dmsmith1991/RainbowBadge/Hardware/avr-6-pin-isp-cable.jpg

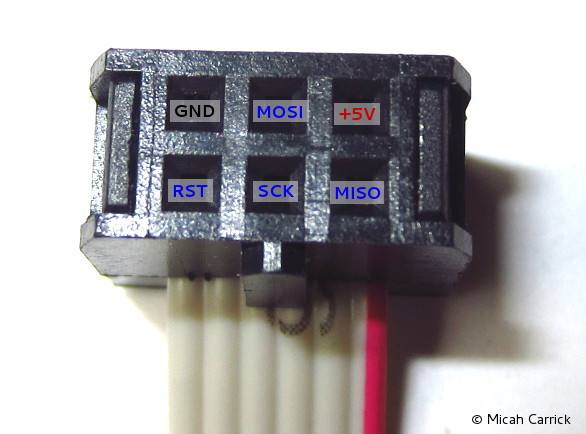
Hardware/avr-6-pin-isp-cable.jpg
