dmsmith1991/RainbowBadge/Hardware/avrpogo2.jpg

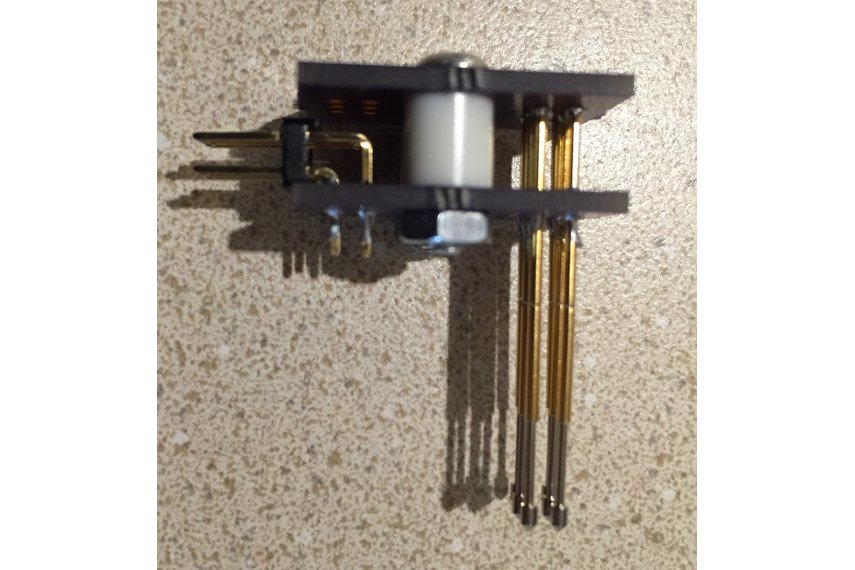
Hardware/avrpogo2.jpg
