dmsmith1991/RainbowBadge/Software/Badge Pattern Customiser.docx

Events

- Tactile Button Press (1-4 buttons)
- Countdown (in Milliseconds)
- Shake (Accelerometer)

Badge Interface Protocol

Communication interface: Serial over USB, 9600 baud 8N1.

Commands

1) Return Firmware Information
  a. ?
  b. Response: RainbowBadgeDemoFW V1.00
2) Clear Receive Buffer
  a. –
  b. Response: CLR
3) SetEvent
  a. E[0] = 1,2
    i. E is the command keychar.
    ii. 0 is the event type (button 1 pressed, button 2 pressed, shake etc.).
    iii. Values after the equals sign are event specific configuration values. These include the enabled state of the event, the event action (what to do when the event is detected e.g. goto next frame, goto previous frame, goto specific frame, goto random frame, increase brightness, decrease brightness etc.).
4) Set Frame Pointer
  a. F = 0
    i. F is the command keychar.
    ii. 0 is the frame index.
  b. Used to point to a specific frame when changing it’s LED colours etc.
5) Set Number Of Frames
  a. N = 0
    i. N is the command keychar.
    ii. 0 is the number of frames stored in EEPROM.
6) Set LED Colour (applies to LEDs in current frame)
  a. L[0] = 255,255,255
    i. L is the command keychar.
    ii. 0 is the LED index (0-24).
    iii. First curly brace argument is the Red colour value.
    iv. Second curly brace argument is the Green colour value.
    v. Third curly brace argument is the Blue colour value.
7) Set Global LED Brightness (on badge poweron)
  a. B = 0
    i. B is the command keychar.
    ii. 0 is the brightness (10 - 250).
