dmsmith1991/RainbowBadge/Hardware/avrpogo1.jpg

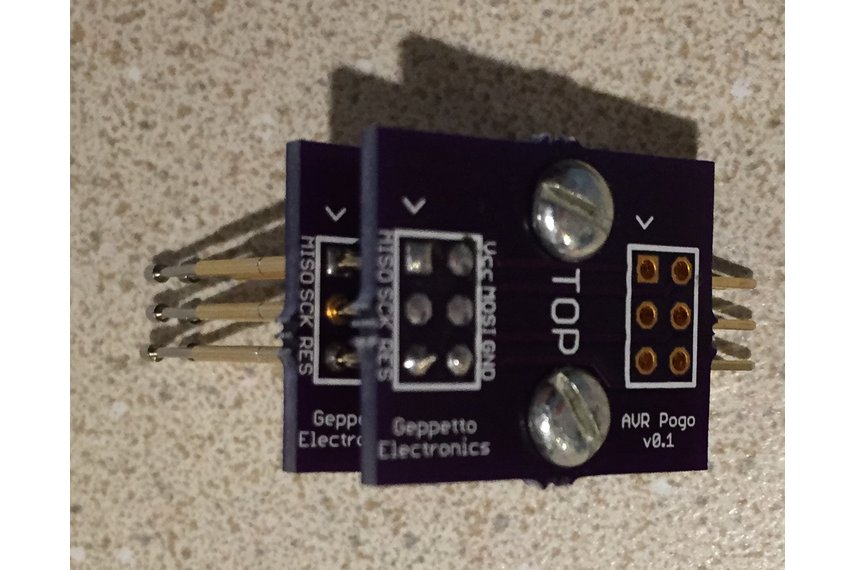
Hardware/avrpogo1.jpg
