dmsmith1991/RainbowBadge/Hardware/DipTrace/OSHPark Renders/Rev. A/bottom.png

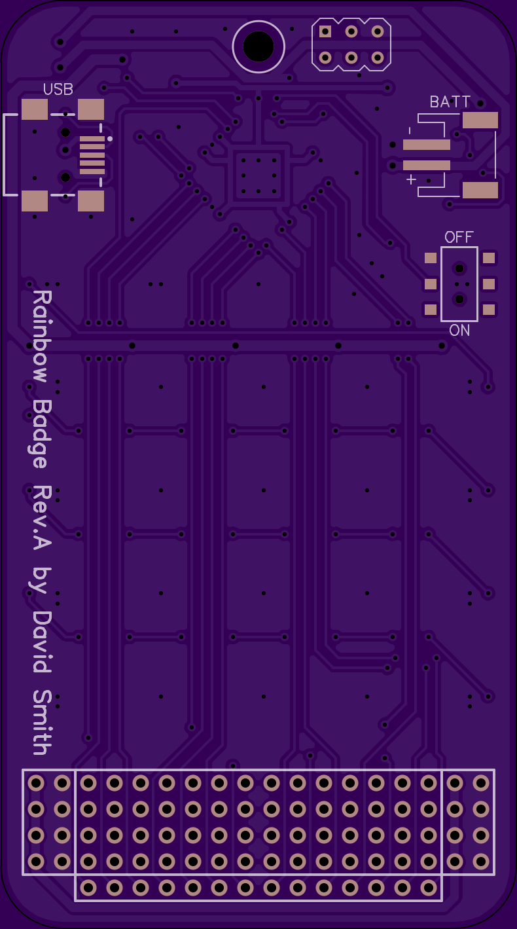
Hardware/DipTrace/OSHPark Renders/Rev. A/bottom.png
