dmsmith1991/RainbowBadge/Hardware/DipTrace/OSHPark Renders/Rev. A/top.png

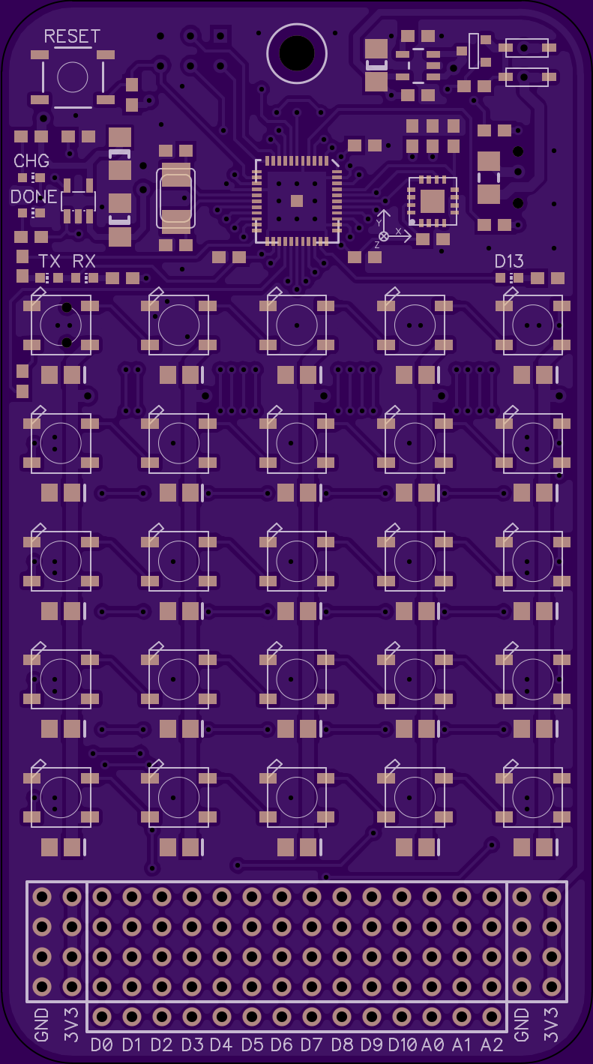
Hardware/DipTrace/OSHPark Renders/Rev. A/top.png
