dmsmith1991/RainbowBadge/Images/2015-01-17 16.46.09.jpg

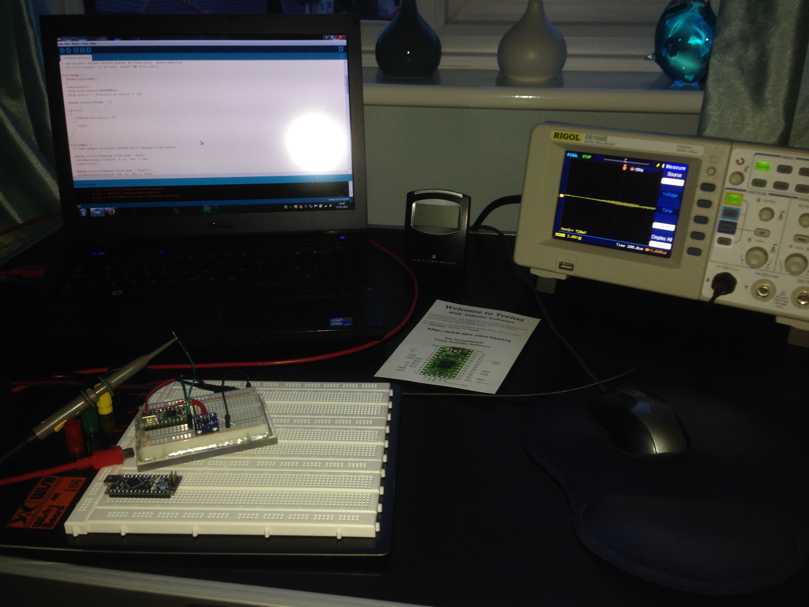
Images/2015-01-17 16.46.09.jpg
