dmsmith1991/RainbowBadge/Images/2015-05-24 18.30.36.jpg

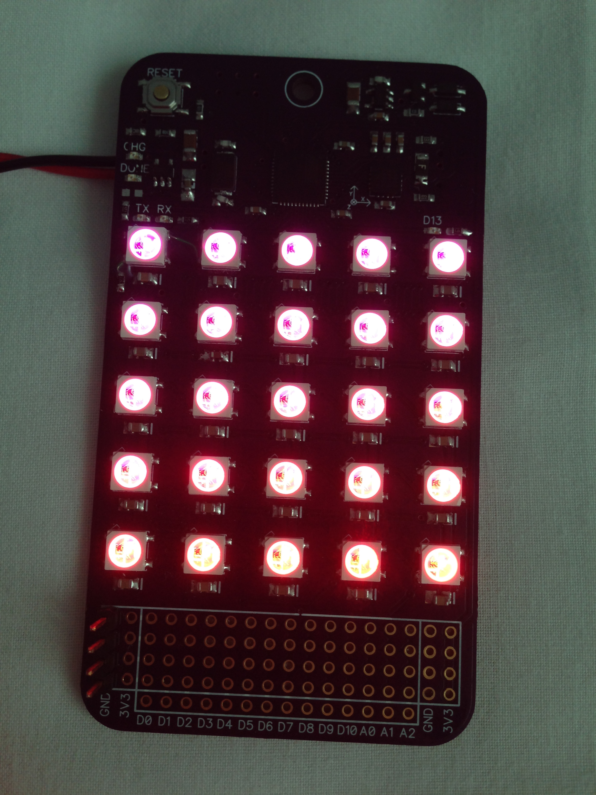
Images/2015-05-24 18.30.36.jpg
