dmsmith1991/RainbowBadge/Images/Screenshot 2014-12-24 21.52.03.png

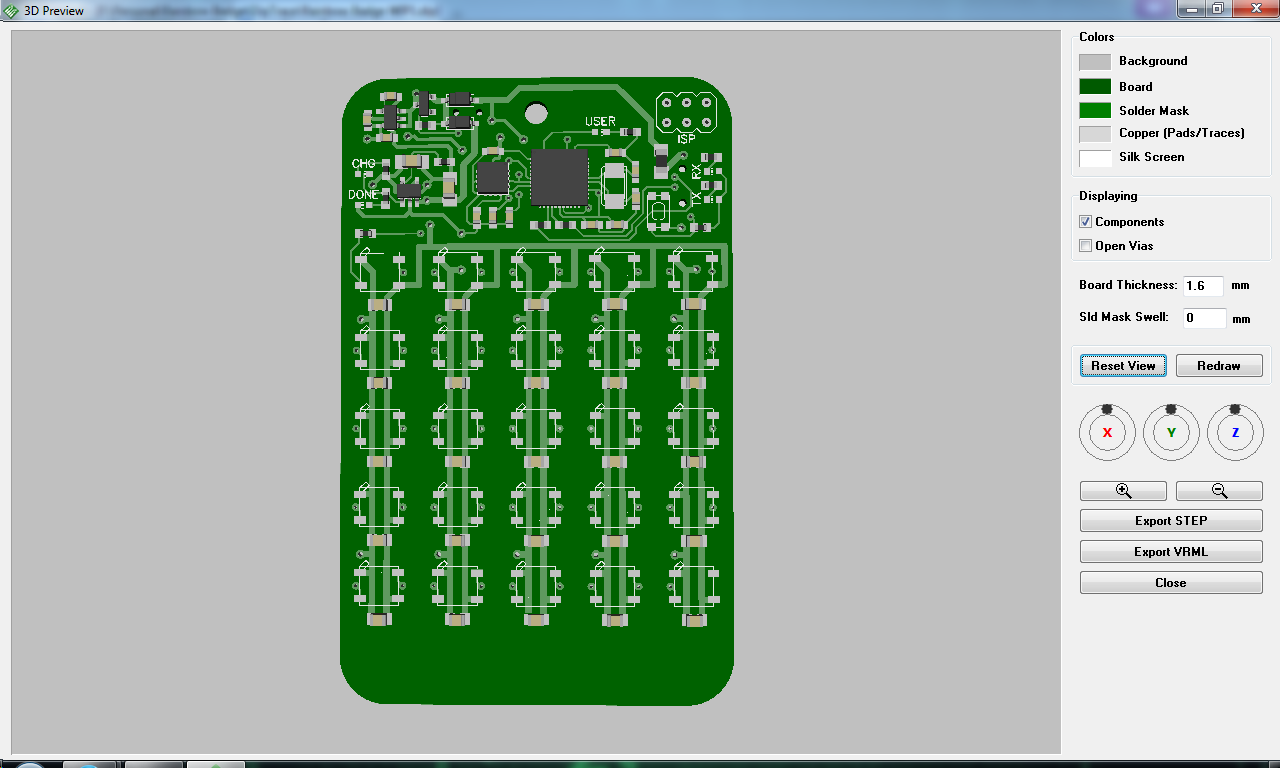
Images/Screenshot 2014-12-24 21.52.03.png
