dmsmith1991/RainbowBadge/Images/Screenshot 2014-12-31 17.28.37.png

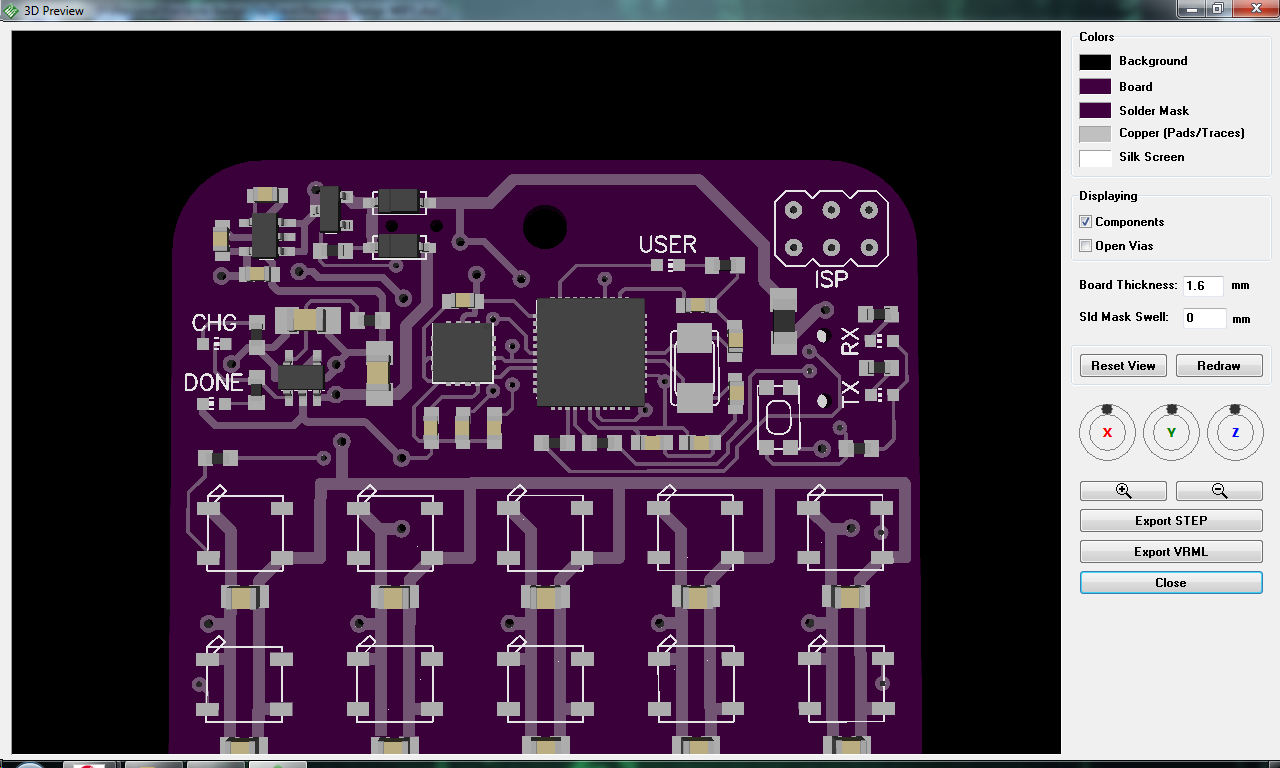
Images/Screenshot 2014-12-31 17.28.37.png
