dmsmith1991/RainbowBadge/Images/Screenshot 2015-01-02 10.49.31.png

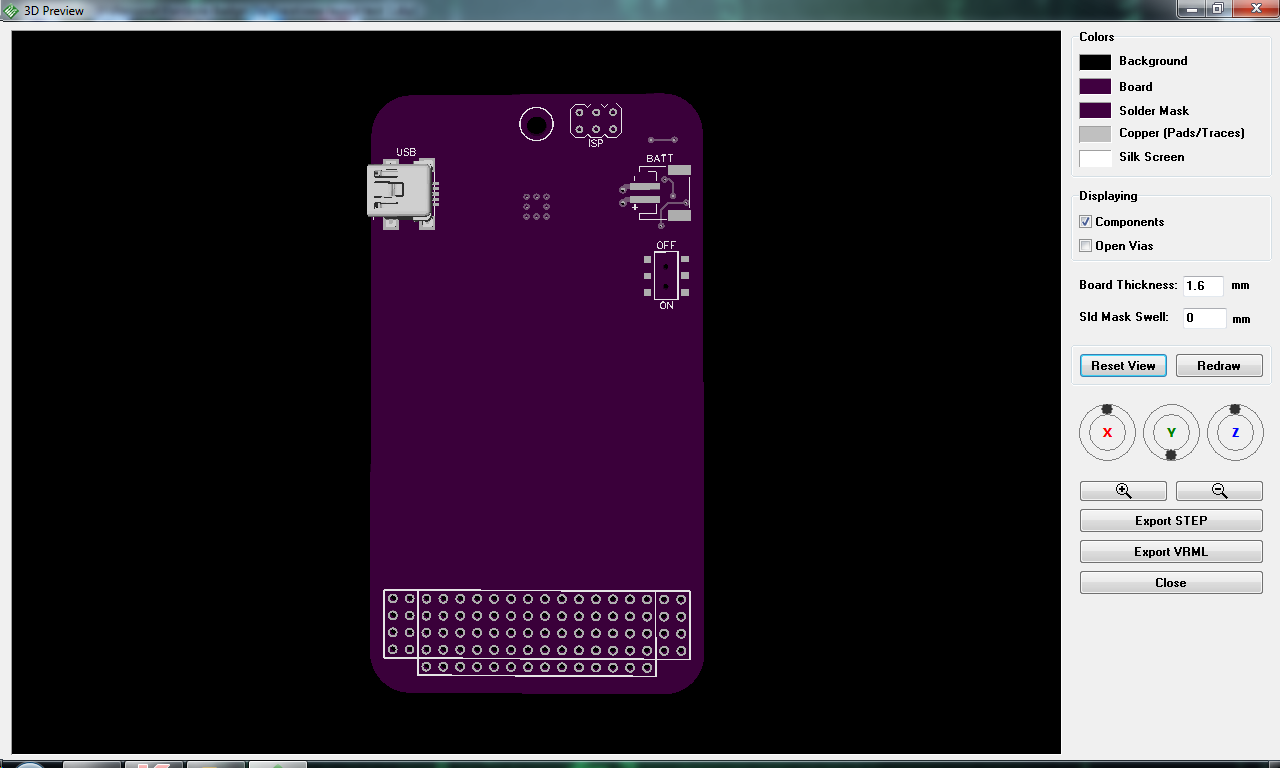
Images/Screenshot 2015-01-02 10.49.31.png
