dmsmith1991/RainbowBadge/Needs Sorting/2013.02.02-MCP73831-schematics.png

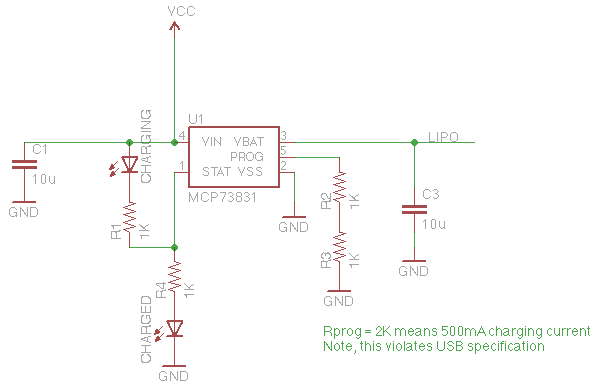
Needs Sorting/2013.02.02-MCP73831-schematics.png
