dmsmith1991/RainbowBadge/Needs Sorting/components.txt

sCHOTTKY DIODE - MBRX120TPMSCT-ND (DIGIKEY)
