dmsmith1991/RainbowBadge/Hardware/Costings - Medium Run.xlsx

Sheet: BOM - Rev. B
Part Name | Manufacturer | Manufacturer Part # | Supplier | Supplier Part # | Qty Per Unit
USB Mini-B Connector | TE CONNECTIVITY | 1734035-1 | Farnell | 1654060 | 1
2-Pin Battery Connector | JST | S2B-PH-SM4-TB(LF)(SN) | Farnell | 9492615 | 1
SMD Slide Switch | C & K COMPONENTS | AYZ0202AGRLC | Farnell | 2319973 | 1
SMD Tactile Switch | ALPS | SKQGAFE010 | Farnell | 2056843 | 1
P-Channel MOSFET | INTERNATIONAL RECTIFIER | IRLML2246TRPBF | Farnell | 1888166 | 1
3.3V LDO Regulator | MICREL SEMICONDUCTOR | MIC5219-3.3YM5 TR | Farnell | 2219097 | 1
ATMEGA32U4 MCU | ATMEL | ATMEGA32U4-MU | Farnell | 2425127 | 1
3-Axis Accelerometer | ANALOG DEVICES | ADXL335BCPZ | Farnell | 2068032 | 1
LiPo Charge Controller IC | MICROCHIP | MCP73831T-2ACI/OT | Farnell | 1332158 | 1
8MHz SMD Crystal | ABRACON | ABM3-8.000MHZ-D2Y-T | Farnell | 2101329 | 1
WS2812B RGB LED |  | WS2812B | eBay |  | 25
22R 0603 Resistor | MULTICOMP | MC0063W0603122R | Farnell | 9330844 | 2
10K 0603 Resistor | MULTICOMP | MC0063W0603110K | Farnell | 9330399 | 2
1K 0603 Resistor | MULTICOMP | MC0063W060311K | Farnell | 9330380 | 2
2K 0603 Resistor | MULTICOMP | MC0063W060312K | Farnell | 9330763 | 1
470R 0603 Resistor | MULTICOMP | MC0063W06031470R | Farnell | 9331239 | 5
470pF 0603 Capacitor | MULTICOMP | MC0603N471J500CT | Farnell | 1759080 | 1
100nF 0603 Capacitor | MULTICOMP | MC0603B104J500CT | Farnell | 2320803 | 7
18pF 0603 Capacitor | MULTICOMP | MC0603N180J500CT | Farnell | 1759056 | 2
1uF 0603 Capacitor | MULTICOMP | MC0603X105K250CT | Farnell | 1759409 | 1
10uF 1206 Capacitor | MULTICOMP | MC1206X106K250CT | Farnell | 2112753 | 3
100nF 0805 Capacitor | MULTICOMP | MC0805B104K500CT | Farnell | 1759265 | 25
Red 0603 LED |  |  | eBay |  | 4
Green 0603 LED |  |  |  |  | 2
Schottky Diode 1A | DIODES INC. | B130LAW-7-F | Farnell | 1858617 | 2
PTC Fuse 500mA | Littelfuse | 1206L050YR | Farnell | 1596993 | 1

Sheet: Costings - Rev. B
Part | Unit Price | Quantity | Total | Total (Inc. VAT)
PCB (OSHPark) | £5.00 | 10 | £50.00 | £50.00
USB Mini-B Connector | £0.78 | 10 | £7.83 | £9.40
2-Pin Battery Connector | £0.24 | 10 | £2.40 | £2.88
SMD Slide Switch | £1.13 | 10 | £11.30 | £13.56
SMD Tactile Switch | £0.22 | 10 | £2.19 | £2.63
P-Channel MOSFET | £0.10 | 10 | £0.99 | £1.19
3.3V LDO Regulator | £0.93 | 10 | £9.28 | £11.14
ATMEGA32U4 MCU | £3.32 | 10 | £33.20 | £39.84
3-Axis Accelerometer | £3.54 | 10 | £35.40 | £42.48
LiPo Charge Controller IC | £0.34 | 10 | £3.36 | £4.03
8MHz SMD Crystal | £0.88 | 10 | £8.75 | £10.50
WS2812B RGB LED | £0.12 | 250 | £29.89 | £29.89
22R 0603 Resistor | £0.03 | 20 | £0.50 | £0.60
10K 0603 Resistor | £0.01 | 20 | £0.22 | £0.26
1K 0603 Resistor | £0.03 | 20 | £0.54 | £0.65
2K 0603 Resistor | £0.03 | 10 | £0.26 | £0.31
470R 0603 Resistor | £0.03 | 50 | £1.35 | £1.62
470pF 0603 Capacitor | £0.01 | 10 | £0.12 | £0.14
100nF 0603 Capacitor | £0.02 | 70 | £1.65 | £1.98
18pF 0603 Capacitor | £0.01 | 20 | £0.17 | £0.20
1uF 0603 Capacitor | £0.02 | 10 | £0.22 | £0.26
10uF 1206 Capacitor | £0.10 | 30 | £3.06 | £3.67
100nF 0805 Capacitor | £0.01 | 250 | £2.35 | £2.82
Red 0603 LED | £0.10 | 40 | £3.96 | £3.96
Green 0603 LED | £0.10 | 20 | £1.98 | £1.98
Schottky Diode 1A | £0.18 | 20 | £3.64 | £4.37
PTC Fuse 500mA | £0.36 | 10 | £3.64 | £4.37
 |  |  | Total Parts Cost: | £244.72
 |  |  | Unit Cost (Complete): | £24.47
 |  |  | Unit Cost (Without Accel.):
 |  |  | Run Quantity: | 10
