dmsmith1991/RainbowBadge/Needs Sorting/Rainbow Badge Test Sheet.xlsx

Rainbow Badge Test Results Sheet - Rev. A
Test No. | Details | Pass / Fail | Notes
1 | Clock at stable 8MHz
2 | Bootloader programmed successfully
3 | D13 LED functional
4 | Strandtest sketch uploaded successfully
5 | TX LED functional
6 | RX LED functional
7 | All Matrix LEDs red capable
8 | All Matrix LEDs green capable
9 | All Matrix LEDs blue capable
10 | All Input/Outputs source capable
11 | All accelerometer axis working
12 | Reset button functioning
13 | 3V3 rail good
14 | On/Off switch working
15 | LiPo charging circuit working
