dmsmith1991/RainbowBadge/(list of files, drawings)

Other design files:
Hardware/DipTrace/ISP Pogo.dip
Hardware/DipTrace/Rainbow Badge Rev. A.dch
Hardware/DipTrace/Rainbow Badge Rev. A.dip
Hardware/DipTrace/Rainbow Badge Rev. B.dip
Hardware/DipTrace/Rainbow Badge WIP1.dch
Hardware/DipTrace/Rainbow Badge WIP1.dip
Hardware/DipTrace/Rainbow Badge WIP2.dip
Needs Sorting/Rainbow Badge.eprj
