dmsmith1991/RainbowBadge/Hardware/Eagle/Rainbow Badge WIP1.sch

## EAGLE design Hardware/Eagle/Rainbow Badge WIP1.sch (2019-04-29)

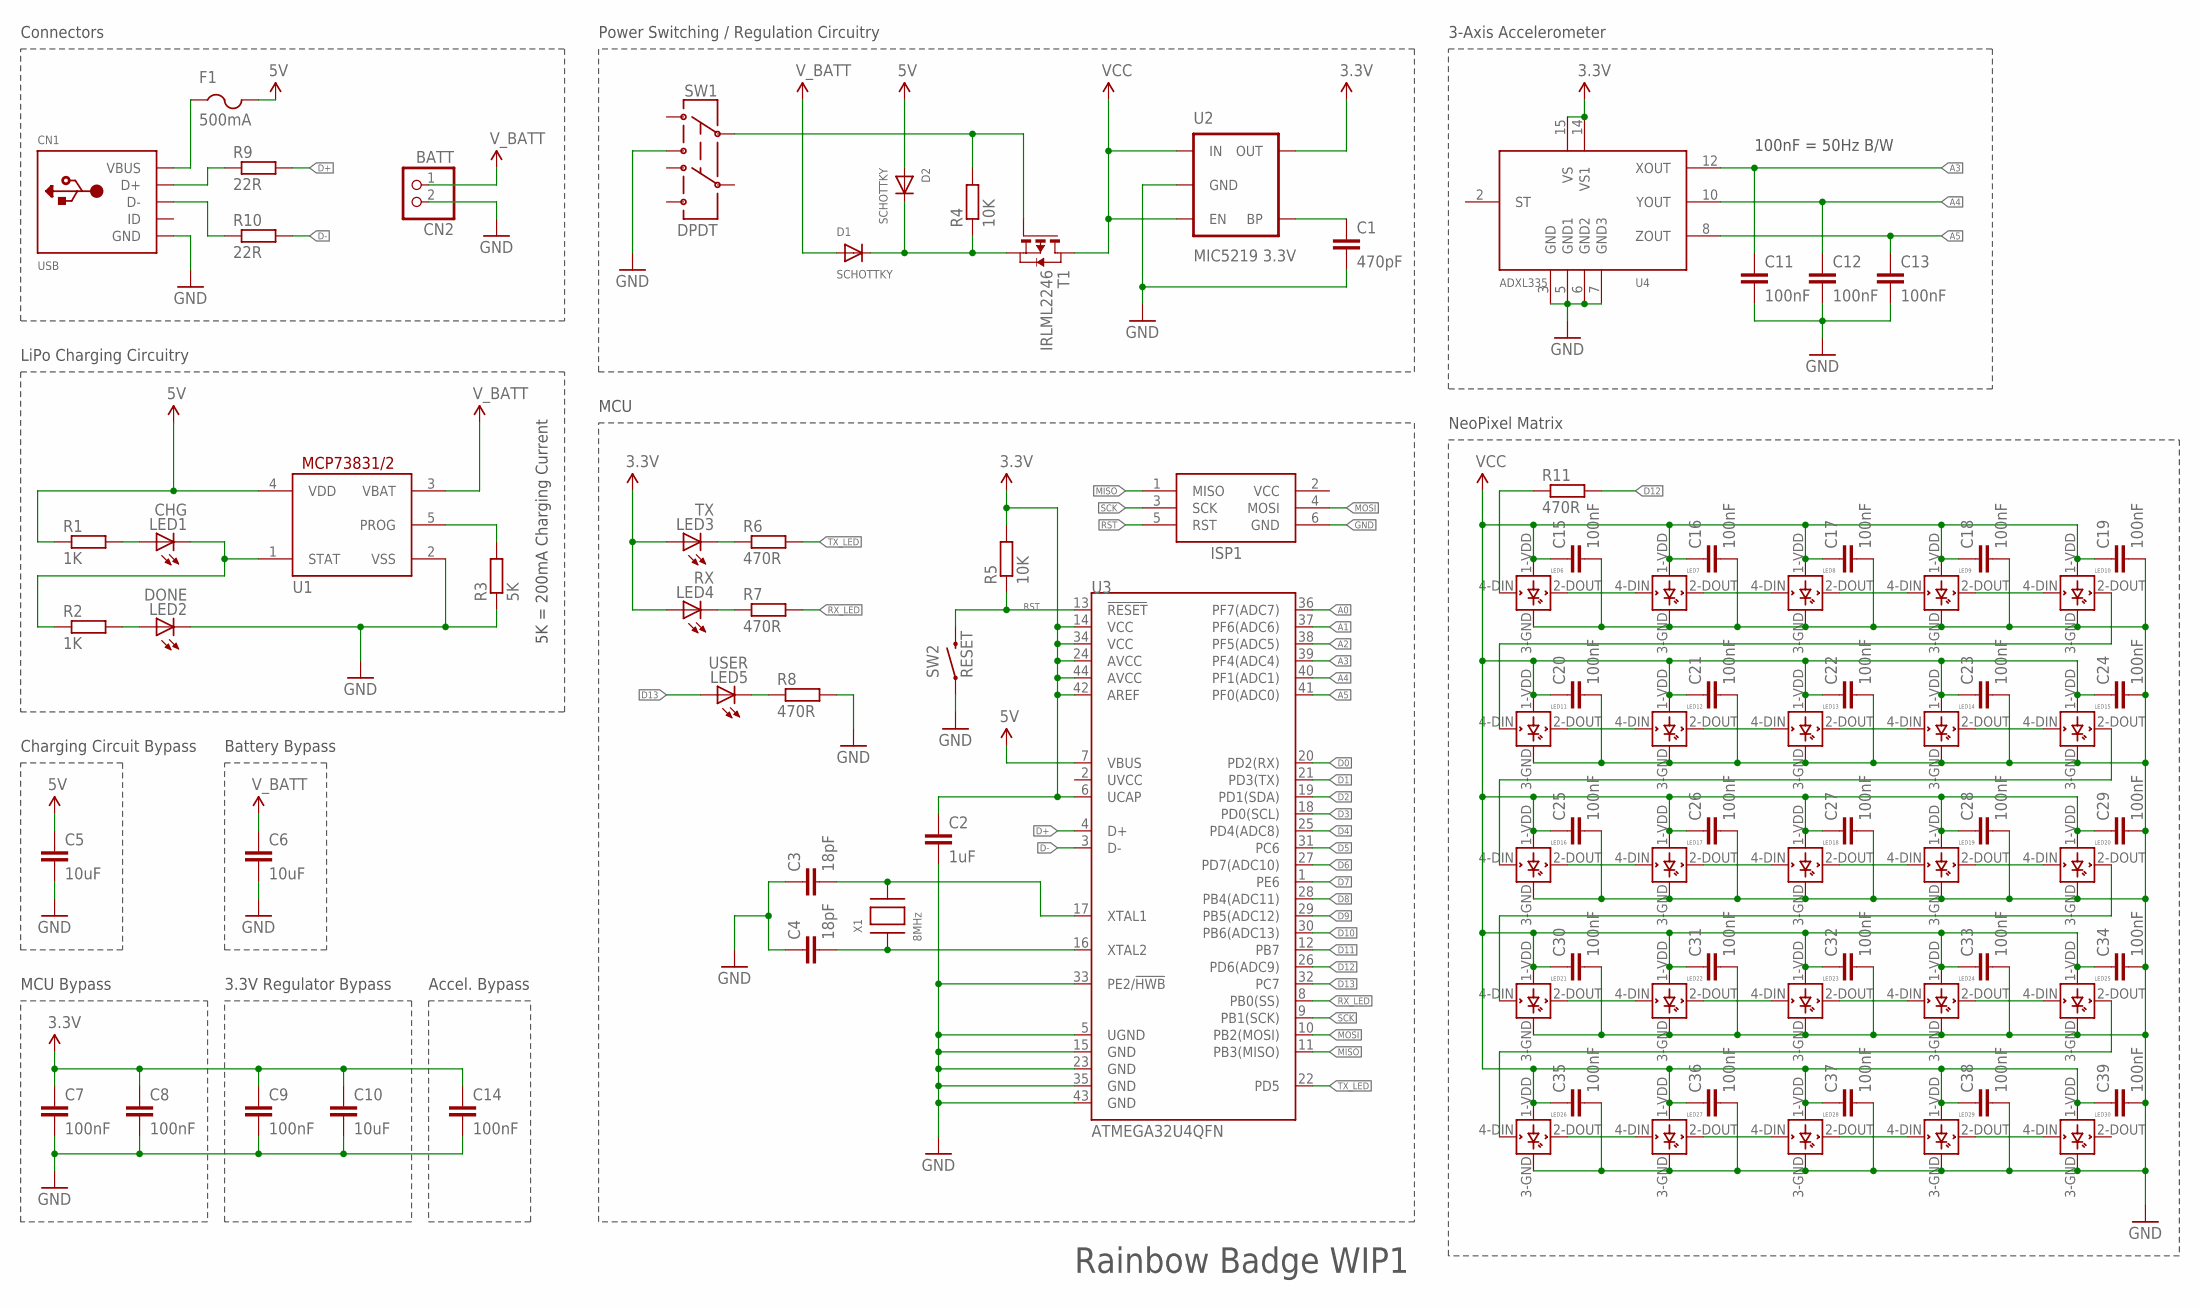
[picture p16: schematic Rainbow Badge WIP1.sch]

Parts:
C1: 470pF; C0603
C2: 1uF; C0603
C3, C4: 18pF; C0603
C5, C6, C10: 10uF; C1206
C7, C8, C9, C11, C12, C13, C14: 100nF; C0603
C15, C16, C17, C18, C19, C20, C21, C22, C23, C24, C25, C26, C27, C28, C29, C30, C31, C32, C33, C34, C35, C36, C37, C38, C39: 100nF; C0805
CN1: USB; USB-MINIB
CN2: BATT; JST-PH-2-SMT-RA
D1, D2: SCHOTTKY; SOD-123
F1: 500mA; R1206
ISP1: AVRISP
LED1: CHG; CHIP-LED0603
LED2: DONE; CHIP-LED0603
LED3: TX; CHIP-LED0603
LED4: RX; CHIP-LED0603
LED5: USER; CHIP-LED0603
LED6, LED7, LED8, LED9, LED10, LED11, LED12, LED13, LED14, LED15, LED16, LED17, LED18, LED19, LED20, LED21, LED22, LED23, LED24, LED25, LED26, LED27, LED28, LED29, LED30: WS2812B
R1, R2: 1K; R0603
R3: 5K; R0603
R4, R5: 10K; R0603
R6, R7, R8, R11: 470R; R0603
R9, R10: 22R; R0603
SW1: DPDT; AYZ0202
SW2: RESET; TACTILE-SWITCH-SMD
T1: IRLML2246; SOT-23
U1: MCP73831/OT; SOT23-5L
U2: MIC5219 3.3V; SOT23-5
U3: ATMEGA32U4QFN; QFN-44
U4: ADXL335; 16LCSP
X1: 8MHz; NX5032

Connections:
3.3V: C2.1, C7.1, C8.1, C9.1, C10.1, C14.1, LED3.A, LED4.A, R5.2, U2.5 (OUT), U3.6 (UCAP), U3.14 (VCC), U3.24 (AVCC), U3.34 (VCC), U3.42 (AREF), U3.44 (AVCC), U4.14 (VS1), U4.15 (VS)
5V: C5.1, D2.A, F1.2, R1.1, U1.4 (VDD), U3.7 (VBUS)
A0: U3.36 (PF7(ADC7))
A1: U3.37 (PF6(ADC6))
A2: U3.38 (PF5(ADC5))
A3: C11.1, U3.39 (PF4(ADC4)), U4.12 (XOUT)
A4: C12.1, U3.40 (PF1(ADC1)), U4.10 (YOUT)
A5: C13.1, U3.41 (PF0(ADC0)), U4.8 (ZOUT)
D0: U3.20 (PD2(RX))
D1: U3.21 (PD3(TX))
D2: U3.19 (PD1(SDA))
D3: U3.18 (PD0(SCL))
D4: U3.25 (PD4(ADC8))
D5: U3.31 (PC6)
D6: U3.27 (PD7(ADC10))
D7: U3.1 (PE6)
D8: U3.28 (PB4(ADC11))
D9: U3.29 (PB5(ADC12))
D10: U3.30 (PB6(ADC13))
D11: U3.12 (PB7)
D12: R11.2, U3.26 (PD6(ADC9))
D13: LED5.A, U3.32 (PC7)
D+: R9.2, U3.4 (D+)
D-: R10.2, U3.3 (D-)
GND: C1.2, C2.2, C3.1, C4.1, C5.2, C6.2, C7.2, C8.2, C9.2, C10.2, C11.2, C12.2, C13.2, C14.2, C15.2, C16.2, C17.2, C18.2, C19.2, C20.2, C21.2, C22.2, C23.2, C24.2, C25.2, C26.2, C27.2, C28.2, C29.2, C30.2, C31.2, C32.2, C33.2, C34.2, C35.2, C36.2, C37.2, C38.2, C39.2, CN1.GND, CN2.2 (1), ISP1.6 (GND), LED2.C, LED6.3-GND (GND), LED7.3-GND (GND), LED8.3-GND (GND), LED9.3-GND (GND), LED10.3-GND (GND), LED11.3-GND (GND), LED12.3-GND (GND), LED13.3-GND (GND), LED14.3-GND (GND), LED15.3-GND (GND), LED16.3-GND (GND), LED17.3-GND (GND), LED18.3-GND (GND), LED19.3-GND (GND), LED20.3-GND (GND), LED21.3-GND (GND), LED22.3-GND (GND), LED23.3-GND (GND), LED24.3-GND (GND), LED25.3-GND (GND), LED26.3-GND (GND), LED27.3-GND (GND), LED28.3-GND (GND), LED29.3-GND (GND), LED30.3-GND (GND), R3.1, R8.2, SW1.3, SW2.1, U1.2 (VSS), U2.2 (GND), U3.5 (UGND), U3.15 (GND), U3.23 (GND), U3.33 (PE2/!HWB), U3.35 (GND), U3.43 (GND), U4.3 (GND), U4.5 (GND1), U4.6 (GND2), U4.7 (GND3)
MISO: ISP1.1 (MISO), U3.11 (PB3(MISO))
MOSI: ISP1.4 (MOSI), U3.10 (PB2(MOSI))
unnamed: LED1.C, R2.1, U1.1 (STAT)
unnamed: LED2.A, R2.2
unnamed: LED1.A, R1.2
unnamed: R3.2, U1.5 (PROG)
unnamed: CN1.VBUS, F1.1
unnamed: LED3.C, R6.1
unnamed: C1.1, U2.4 (BP)
unnamed: R4.2, SW1.2, T1.3 (G)
unnamed: D1.C, D2.C, R4.1, T1.2 (S)
unnamed: C3.2, U3.17 (XTAL1), X1.P$2
unnamed: C4.2, U3.16 (XTAL2), X1.P$1
unnamed: LED4.C, R7.1
unnamed: LED5.C, R8.1
unnamed: CN1.D+, R9.1
unnamed: CN1.D-, R10.1
unnamed: LED6.4-DIN (DIN), R11.1
unnamed: LED6.2-DOUT (DOUT), LED7.4-DIN (DIN)
unnamed: LED7.2-DOUT (DOUT), LED8.4-DIN (DIN)
unnamed: LED8.2-DOUT (DOUT), LED9.4-DIN (DIN)
unnamed: LED9.2-DOUT (DOUT), LED10.4-DIN (DIN)
unnamed: LED11.2-DOUT (DOUT), LED12.4-DIN (DIN)
unnamed: LED12.2-DOUT (DOUT), LED13.4-DIN (DIN)
unnamed: LED13.2-DOUT (DOUT), LED14.4-DIN (DIN)
unnamed: LED14.2-DOUT (DOUT), LED15.4-DIN (DIN)
unnamed: LED16.2-DOUT (DOUT), LED17.4-DIN (DIN)
unnamed: LED17.2-DOUT (DOUT), LED18.4-DIN (DIN)
unnamed: LED18.2-DOUT (DOUT), LED19.4-DIN (DIN)
unnamed: LED19.2-DOUT (DOUT), LED20.4-DIN (DIN)
unnamed: LED21.2-DOUT (DOUT), LED22.4-DIN (DIN)
unnamed: LED22.2-DOUT (DOUT), LED23.4-DIN (DIN)
unnamed: LED23.2-DOUT (DOUT), LED24.4-DIN (DIN)
unnamed: LED24.2-DOUT (DOUT), LED25.4-DIN (DIN)
unnamed: LED26.2-DOUT (DOUT), LED27.4-DIN (DIN)
unnamed: LED27.2-DOUT (DOUT), LED28.4-DIN (DIN)
unnamed: LED28.2-DOUT (DOUT), LED29.4-DIN (DIN)
unnamed: LED29.2-DOUT (DOUT), LED30.4-DIN (DIN)
unnamed: LED10.2-DOUT (DOUT), LED11.4-DIN (DIN)
unnamed: LED15.2-DOUT (DOUT), LED16.4-DIN (DIN)
unnamed: LED20.2-DOUT (DOUT), LED21.4-DIN (DIN)
unnamed: LED25.2-DOUT (DOUT), LED26.4-DIN (DIN)
RST: ISP1.5 (RST), R5.1, SW2.3 (2), U3.13 (!RESET)
RX_LED: R7.2, U3.8 (PB0(SS))
SCK: ISP1.3 (SCK), U3.9 (PB1(SCK))
TX_LED: R6.2, U3.22 (PD5)
VCC: C15.1, C16.1, C17.1, C18.1, C19.1, C20.1, C21.1, C22.1, C23.1, C24.1, C25.1, C26.1, C27.1, C28.1, C29.1, C30.1, C31.1, C32.1, C33.1, C34.1, C35.1, C36.1, C37.1, C38.1, C39.1, LED6.1-VDD (VDD), LED7.1-VDD (VDD), LED8.1-VDD (VDD), LED9.1-VDD (VDD), LED10.1-VDD (VDD), LED11.1-VDD (VDD), LED12.1-VDD (VDD), LED13.1-VDD (VDD), LED14.1-VDD (VDD), LED15.1-VDD (VDD), LED16.1-VDD (VDD), LED17.1-VDD (VDD), LED18.1-VDD (VDD), LED19.1-VDD (VDD), LED20.1-VDD (VDD), LED21.1-VDD (VDD), LED22.1-VDD (VDD), LED23.1-VDD (VDD), LED24.1-VDD (VDD), LED25.1-VDD (VDD), LED26.1-VDD (VDD), LED27.1-VDD (VDD), LED28.1-VDD (VDD), LED29.1-VDD (VDD), LED30.1-VDD (VDD), T1.1 (D), U2.1 (IN), U2.3 (EN)
V_BATT: C6.1, CN2.1 (2), D1.A, U1.3 (VBAT)

Notes on the sheet:
Power Switching / Regulation Circuitry
LiPo Charging Circuitry
Connectors
Battery Bypass
MCU Bypass
3.3V Regulator Bypass
Charging Circuit Bypass
MCU
5K = 200mA Charging Current
Rainbow Badge WIP1
3-Axis Accelerometer
Accel. Bypass
100nF = 50Hz B/W
NeoPixel Matrix
