dmsmith1991/RainbowBadge/Software/Arduino/Sketches/RainbowBadge_StrandTest/RainbowBadge_StrandTest.ino

#include <EEPROM.h>
#include <Adafruit_NeoPixel.h>

#define MATRIX_PIN 12
#define LED_PIN 13

#define RUNNINGTIME_ADDR 0

//#define TEST_MODE

// Parameter 1 = number of pixels in strip
// Parameter 2 = Arduino pin number (most are valid)
// Parameter 3 = pixel type flags, add together as needed:
//   NEO_KHZ800  800 KHz bitstream (most NeoPixel products w/WS2812 LEDs)
//   NEO_KHZ400  400 KHz (classic 'v1' (not v2) FLORA pixels, WS2811 drivers)
//   NEO_GRB     Pixels are wired for GRB bitstream (most NeoPixel products)
//   NEO_RGB     Pixels are wired for RGB bitstream (v1 FLORA pixels, not v2)
Adafruit_NeoPixel strip = Adafruit_NeoPixel(25, MATRIX_PIN, NEO_GRB + NEO_KHZ800);

// IMPORTANT: To reduce NeoPixel burnout risk, add 1000 uF capacitor across
// pixel power leads, add 300 - 500 Ohm resistor on first pixel's data input
// and minimize distance between Arduino and first pixel.  Avoid connecting
// on a live circuit...if you must, connect GND first.

unsigned long startTime;

void setup()
{
  strip.begin();
  strip.setBrightness(40);
  strip.show(); // Initialize all pixels to 'off'

  /*
  Serial.begin(9600);
  
  pinMode(LED_PIN, OUTPUT);
  digitalWrite(LED_PIN, LOW);
  while(!Serial)
  {
    digitalWrite(LED_PIN, HIGH);
    delay(100);
    digitalWrite(LED_PIN, LOW);
    delay(100);
  }
  
  unsigned long timeValue = EEPROM_ReadLong(RUNNINGTIME_ADDR);
  Serial.print("Last Running Time: ");
  Serial.print(timeValue);
  Serial.println(" seconds.");
  Serial.println("Press any key to start...");
  
  while(1)
  {
    if(Serial.available() > 0)
    {
      break;
    }
  }
  
  ClearRunningTimeValue();
  Serial.println("Test started, please disconnect USB!");
  
  startTime = millis();
  */
}

void loop()
{
  // Some example procedures showing how to display to the pixels:
  colorWipe(strip.Color(255, 0, 0), 100); // Red
  colorWipe(strip.Color(0, 255, 0), 100); // Green
  colorWipe(strip.Color(0, 0, 255), 100); // Blue
  colorWipe(strip.Color(127, 127, 127), 100); // White
  
  // Send a theater pixel chase in...
  theaterChase(strip.Color(255, 0, 0), 100); // Red
  theaterChase(strip.Color(0, 255, 0), 100); // Green
  theaterChase(strip.Color(0, 0, 255), 100); // Blue
  theaterChase(strip.Color(127, 127, 127), 100); // White

  rainbow(50);
  rainbowCycle(50);
  theaterChaseRainbow(100);
  
  #ifdef TEST_MODE
  UpdateRunningTimeValue();
  #endif
}

// Fill the dots one after the other with a color
void colorWipe(uint32_t c, uint8_t wait) {
  for(uint16_t i=0; i<strip.numPixels(); i++) {
      strip.setPixelColor(i, c);
      strip.show();
      delay(wait);
  }
}

void rainbow(uint8_t wait) {
  uint16_t i, j;

  for(j=0; j<256; j++) {
    for(i=0; i<strip.numPixels(); i++) {
      strip.setPixelColor(i, Wheel((i+j) & 255));
    }
    strip.show();
    delay(wait);
  }
}

// Slightly different, this makes the rainbow equally distributed throughout
void rainbowCycle(uint8_t wait) {
  uint16_t i, j;

  for(j=0; j<256*5; j++) { // 5 cycles of all colors on wheel
    for(i=0; i< strip.numPixels(); i++) {
      strip.setPixelColor(i, Wheel(((i * 256 / strip.numPixels()) + j) & 255));
    }
    strip.show();
    delay(wait);
  }
}

//Theatre-style crawling lights.
void theaterChase(uint32_t c, uint8_t wait) {
  for (int j=0; j<10; j++) {  //do 10 cycles of chasing
    for (int q=0; q < 3; q++) {
      for (int i=0; i < strip.numPixels(); i=i+3) {
        strip.setPixelColor(i+q, c);    //turn every third pixel on
      }
      strip.show();
     
      delay(wait);
     
      for (int i=0; i < strip.numPixels(); i=i+3) {
        strip.setPixelColor(i+q, 0);        //turn every third pixel off
      }
    }
  }
}

//Theatre-style crawling lights with rainbow effect
void theaterChaseRainbow(uint8_t wait) {
  for (int j=0; j < 256; j++) {     // cycle all 256 colors in the wheel
    for (int q=0; q < 3; q++) {
        for (int i=0; i < strip.numPixels(); i=i+3) {
          strip.setPixelColor(i+q, Wheel( (i+j) % 255));    //turn every third pixel on
        }
        strip.show();
       
        delay(wait);
       
        for (int i=0; i < strip.numPixels(); i=i+3) {
          strip.setPixelColor(i+q, 0);        //turn every third pixel off
        }
    }
  }
}

// Input a value 0 to 255 to get a color value.
// The colours are a transition r - g - b - back to r.
uint32_t Wheel(byte WheelPos) {
  WheelPos = 255 - WheelPos;
  if(WheelPos < 85) {
   return strip.Color(255 - WheelPos * 3, 0, WheelPos * 3);
  } else if(WheelPos < 170) {
    WheelPos -= 85;
   return strip.Color(0, WheelPos * 3, 255 - WheelPos * 3);
  } else {
   WheelPos -= 170;
   return strip.Color(WheelPos * 3, 255 - WheelPos * 3, 0);
  }
}

void UpdateRunningTimeValue(void)
{
  unsigned long timeOn = (millis() - startTime) / 1000; // Store seconds.
  EEPROM_WriteLong(RUNNINGTIME_ADDR, timeOn);
  // Serial.print("*** Time Updated: ");
  // Serial.print(timeOn);
  // Serial.println(" seconds ***");
}

void ClearRunningTimeValue(void)
{
  EEPROM_WriteLong(RUNNINGTIME_ADDR, 0);
}

//This function will write a 4 byte (32bit) long to the eeprom at
//the specified address to adress + 3.
void EEPROM_WriteLong(int address, unsigned long value)
{
  //Decomposition from a long to 4 bytes by using bitshift.
  //One = Most significant -> Four = Least significant byte
  byte four = (value & 0xFF);
  byte three = ((value >> 8) & 0xFF);
  byte two = ((value >> 16) & 0xFF);
  byte one = ((value >> 24) & 0xFF);
  
  //Write the 4 bytes into the eeprom memory.
  EEPROM.write(address, four);
  EEPROM.write(address + 1, three);
  EEPROM.write(address + 2, two);
  EEPROM.write(address + 3, one);
}

unsigned long EEPROM_ReadLong(unsigned long address)
{
  //Read the 4 bytes from the eeprom memory.
  unsigned long four = EEPROM.read(address);
  unsigned long three = EEPROM.read(address + 1);
  unsigned long two = EEPROM.read(address + 2);
  unsigned long one = EEPROM.read(address + 3);
  
  //Return the recomposed long by using bitshift.
  return ((four << 0) & 0xFF) + ((three << 8) & 0xFFFF) + ((two << 16) & 0xFFFFFF) + ((one << 24) & 0xFFFFFFFF);
}
